unionpronet/github-xmc-lora-sensor/images/system-block.jpg

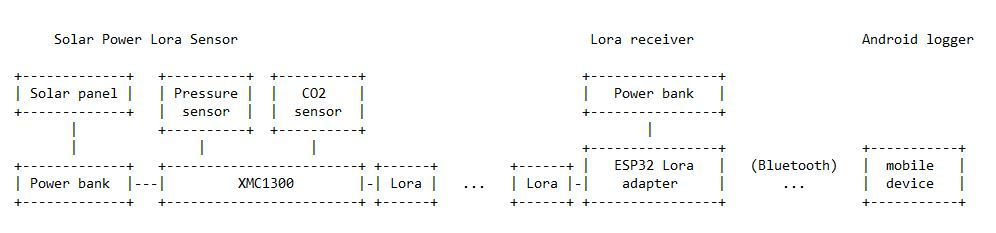
images/system-block.jpg
