unionpronet/github-xmc-lora-sensor/doc/xmc-lora-sensor-sch-v1.0.pdf

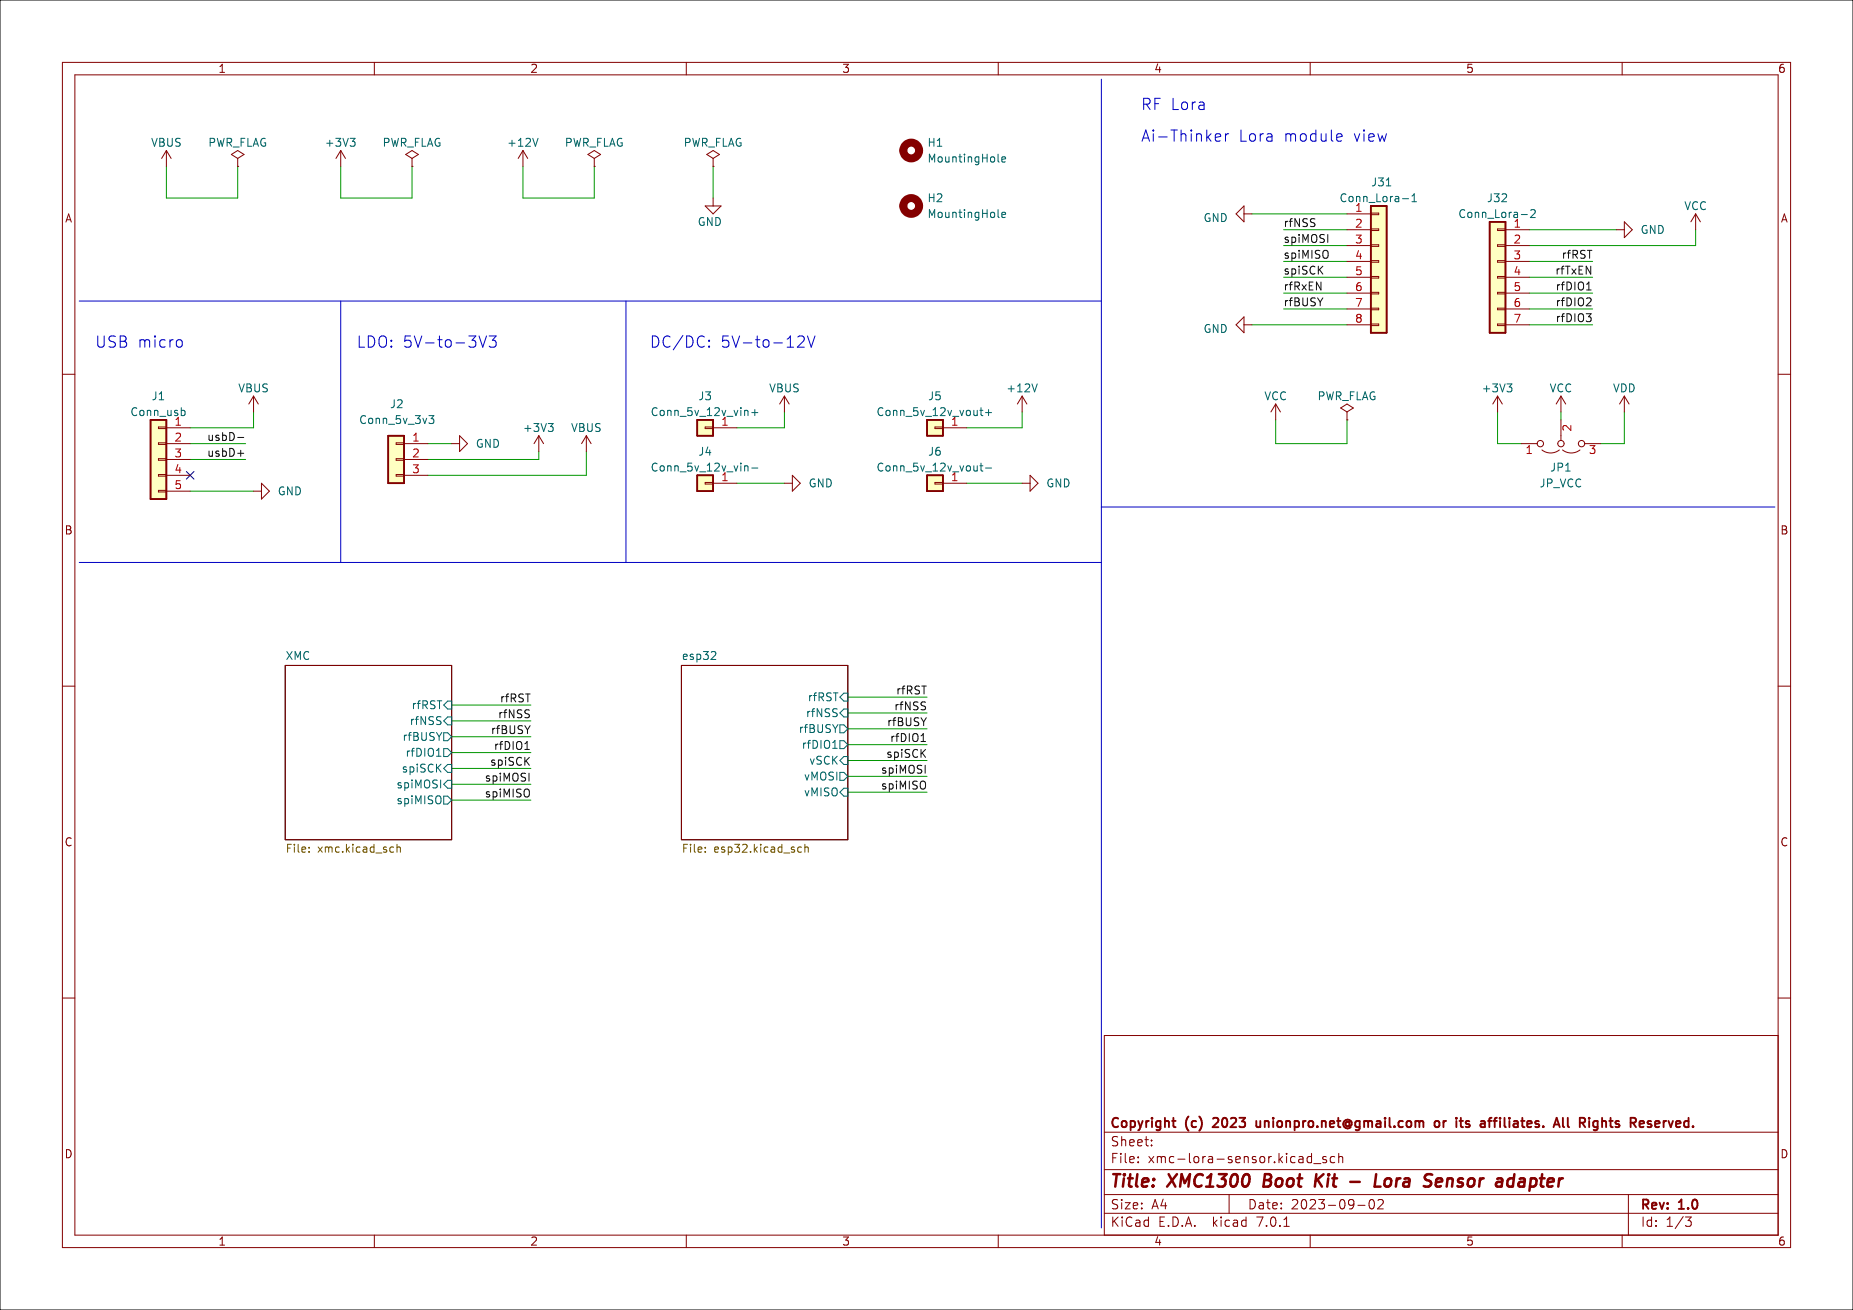
[picture p8: page 1]

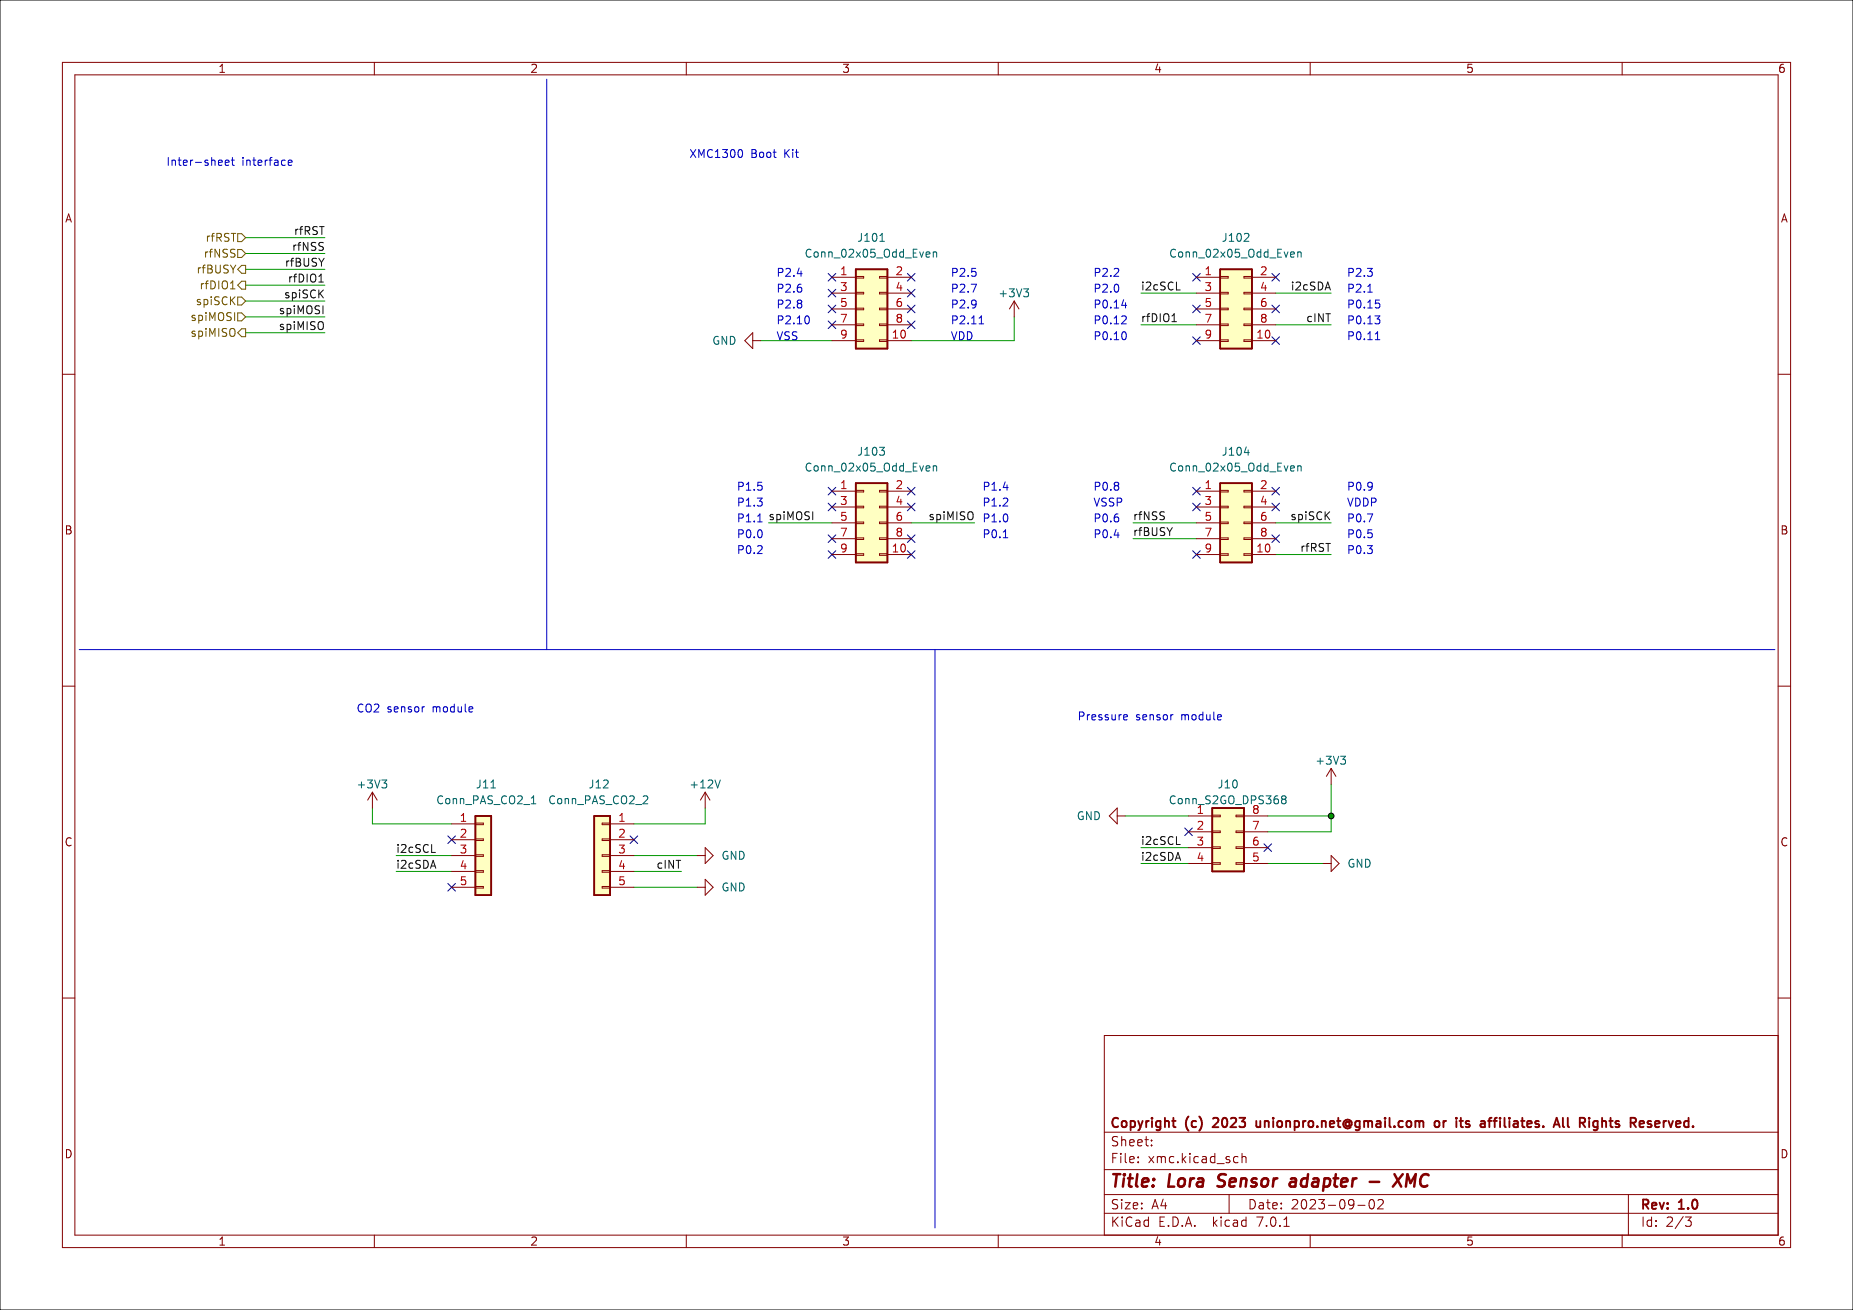
[picture p9: page 2]

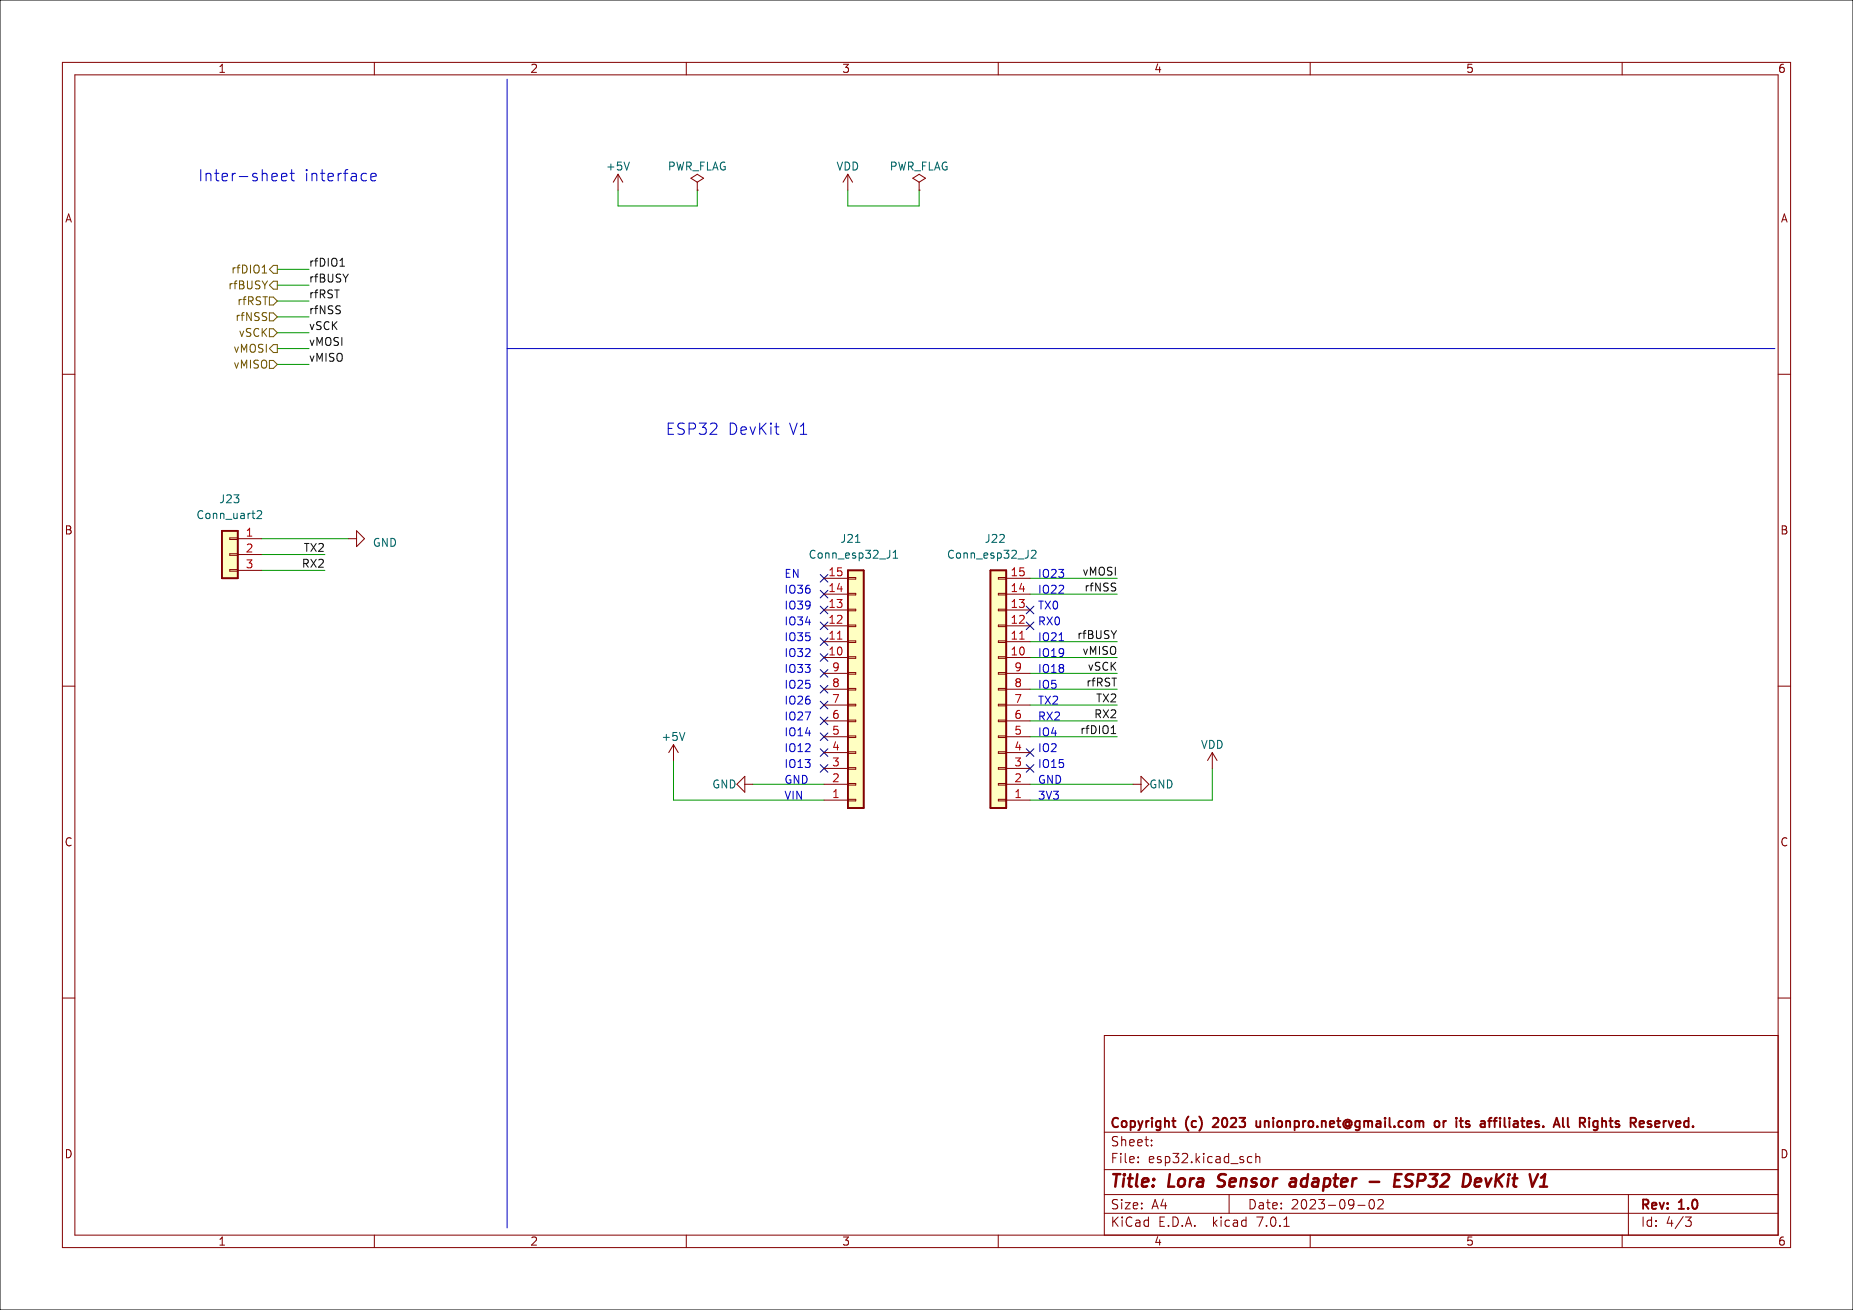
[picture p10: page 3]
