unionpronet/github-xmc-lora-sensor/(notices)

Notices in the files:
README.md:
License: LGPL v3
